M000nwalker/Beyond_Horizon_1/CADS/Worm Gear.gif

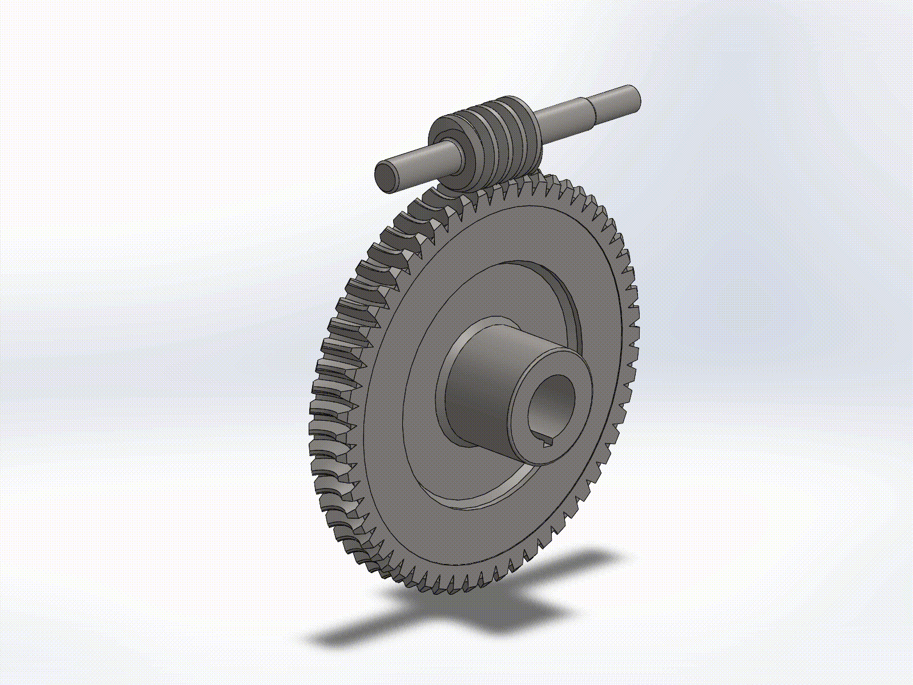
CADS/Worm Gear.gif
