M000nwalker/Beyond_Horizon_1/CADS/worm-gearbox-nema-17-driven-1.snapshot.5/00.png

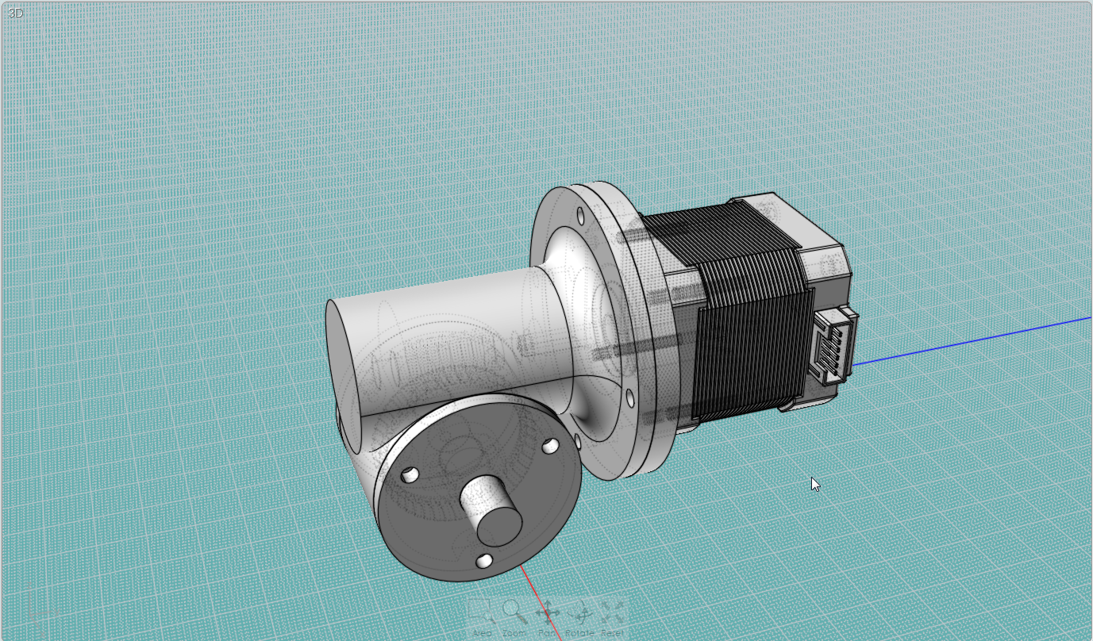
CADS/worm-gearbox-nema-17-driven-1.snapshot.5/00.png
