M000nwalker/Beyond_Horizon_1/Media/photo_2026-10-02_17-45-02.jpg

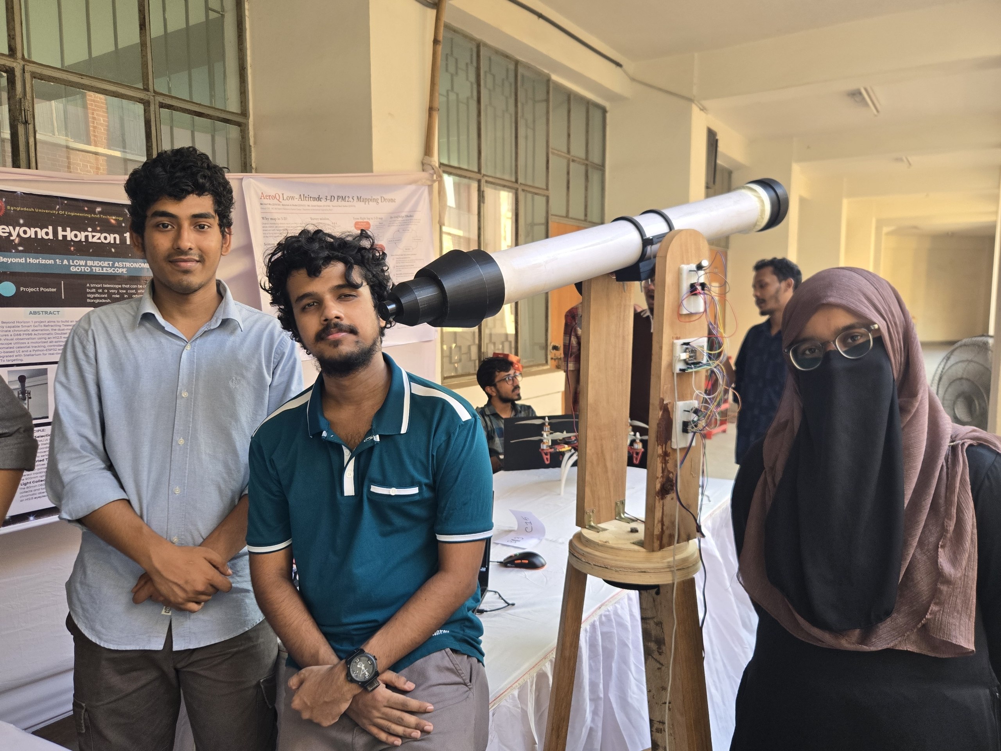
Media/photo_2026-10-02_17-45-02.jpg
