M000nwalker/Beyond_Horizon_1/Media/photo_2026-10-02_17-46-13.jpg

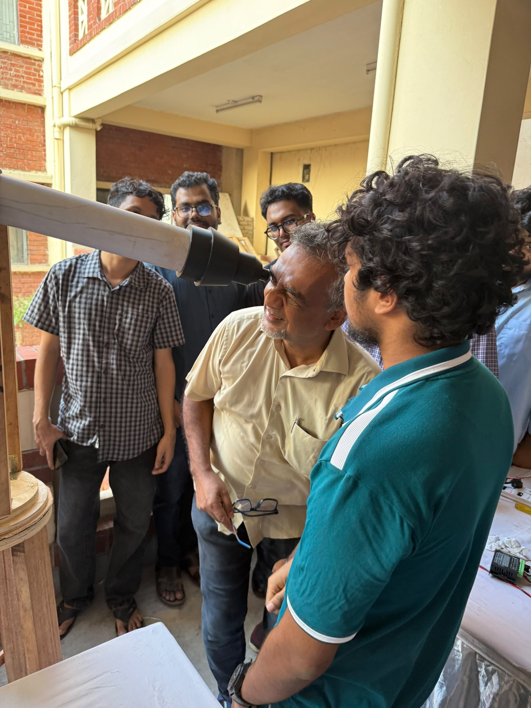
Media/photo_2026-10-02_17-46-13.jpg
