M000nwalker/Beyond_Horizon_1/Web App/Beyond Horizon -1 User Interface/captures/IMG_60D_20260905_001946_005.jpg

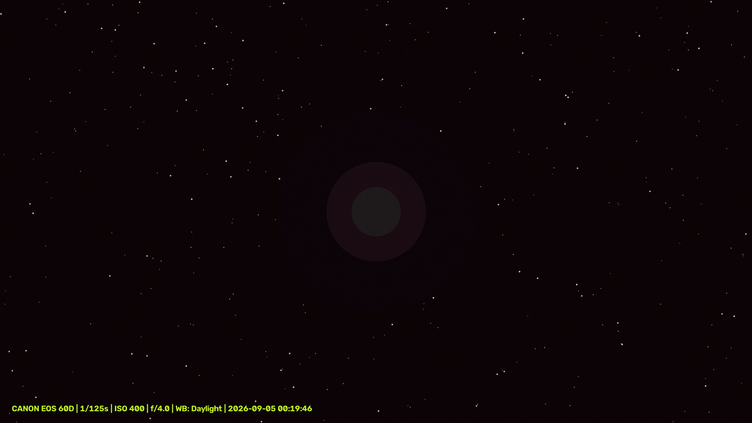
Web App/Beyond Horizon -1 User Interface/captures/IMG_60D_20260905_001946_005.jpg
