M000nwalker/Beyond_Horizon_1/Bill Of Material-BH1/bill_of_materials_BH1.tex

\documentclass[11pt,a4paper]{article}
\usepackage[utf8]{inputenc}
\usepackage[top=2cm, bottom=2cm, left=2.2cm, right=2.2cm]{geometry}
\usepackage{booktabs}
\usepackage{tabularx}
\usepackage{array}

\renewcommand{\familydefault}{\sfdefault}

\begin{document}

\begin{center}
    {\LARGE \textbf{Bill of Materials (BOM)}}\\[1.5ex]
    {\large \textbf{Project BH-1 Expenditure Statement}}\\[1ex]
    \normalsize Date: October 2026 \quad $\vert$ \quad Currency: BDT (Taka)
\end{center}

\vspace{2ex}

\noindent
\renewcommand{\arraystretch}{1.18}
\begin{tabularx}{\linewidth}{@{} c X r @{}}
\toprule
\textbf{SL} & \textbf{Description} & \textbf{Amount (BDT)} \\
\midrule
1  & Optical Parts \& Sourcing (Patuatuli)                        & 1,690 \\
2  & Photocopy \& File Folder                                     & 55 \\
3  & PVC Pipe \& Hacksaw Blade                                    & 180 \\
4  & Document Print                                               & 12 \\
5  & Document Print                                               & 28 \\
6  & Vernier Scale \& ESP32 Microcontroller                       & 1,160 \\
7  & 3D Printing                                                  & 7,500 \\
8  & Material Cutting                                             & 100 \\
9  & Paper \& Screws                                              & 70 \\
10 & Optical Lens                                                 & 6,000 \\
11 & Battery Pack \& Accessories                                  & 2,860 \\
12 & Ball Bearings                                                & 360 \\
13 & Shaft                                                        & 420 \\
14 & Wood                                                         & 1,000 \\
15 & Motor Driver                                                 & 140 \\
16 & Soldering                                        & 160 \\
17 & Carpentry                                                    & 440 \\
18 & Clamps                                                       & 290 \\
19 & Super Glue                                                   & 30 \\
20 & Internet                                                     & 200 \\
21 & Poster \& Conveyance                                         & 280 \\
22 & Optical Eyepiece                                             & 1,600 \\
23 & Motor, Driver \& Component Loss Allowance                    & 2,023 \\
\midrule[\heavyrulewidth]
   & \textbf{Total}                                               & \textbf{26,598} \\
\bottomrule
\end{tabularx}

\end{document}
