M000nwalker/Beyond_Horizon_1/Final Assembly/final assembly.SLDASM

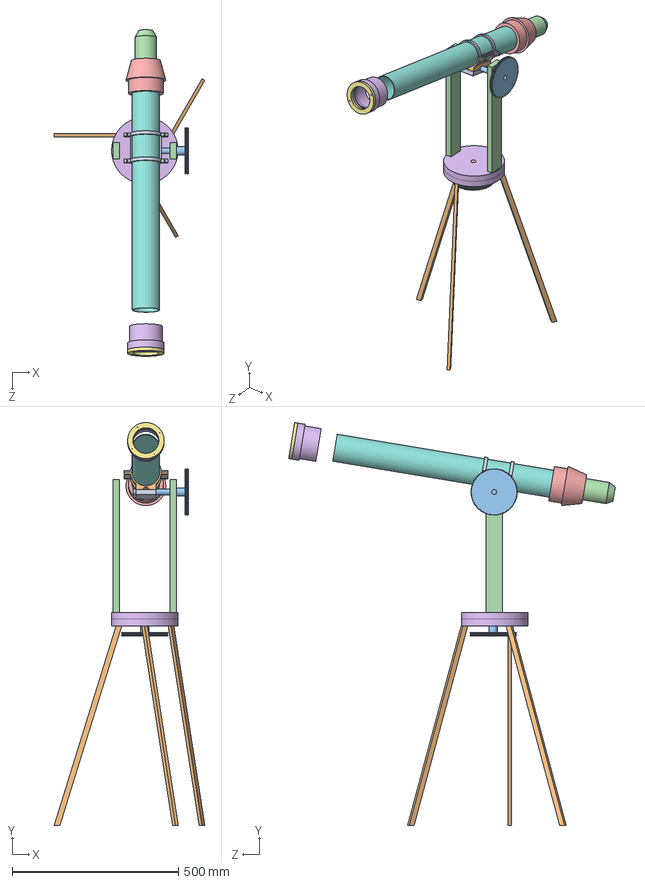
[picture p18: CAD file, 2026-10-15]
Final Assembly/final assembly.SLDASM
453.2 x 1211.3 x 982.1 mm
bases x 2
lower shaft
standing part x 2
upper shaft
Lower Holder
Lower Part with the shaft
PVC pipe
Ready To Print Lens Cap
Ready To Print Lens Cell
Ready To Print Static Focuser
Ready To Print Slider
wormwheel x 2
leg x 3
Upper Holder
