M000nwalker/Beyond_Horizon_1/CADS/upperplatform2.0/gear.SLDASM

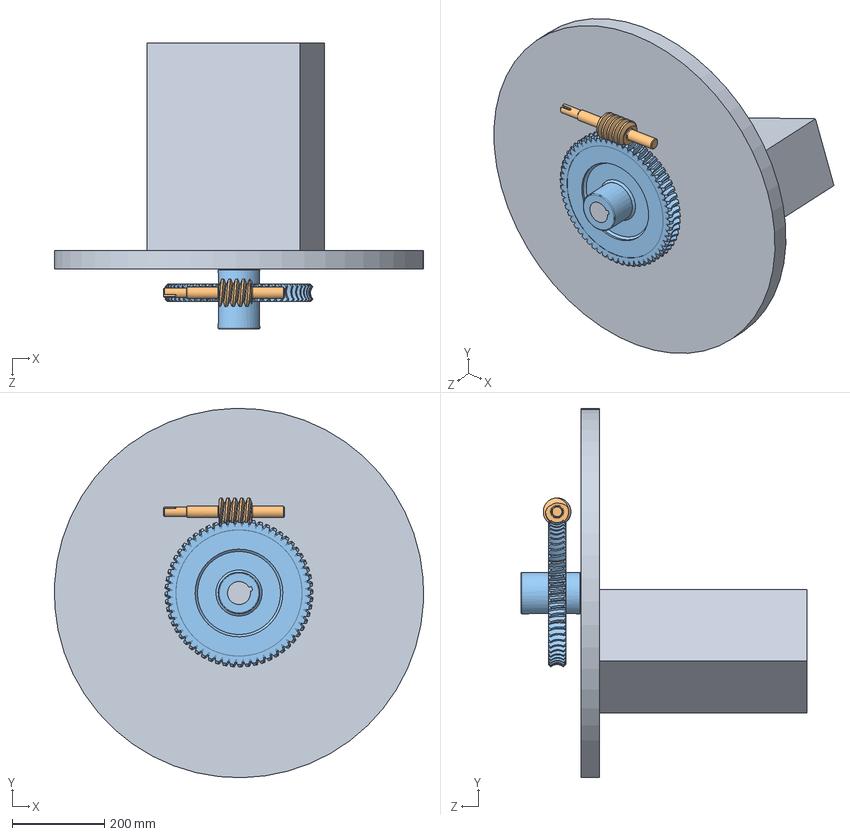
[picture p19: CAD file, 2026-07-25]
CADS/upperplatform2.0/gear.SLDASM
799.1 x 799.9 x 620.0 mm
Upper platform
