M000nwalker/Beyond_Horizon_1/CADS/Printables-1/Assem lower platform.SLDASM

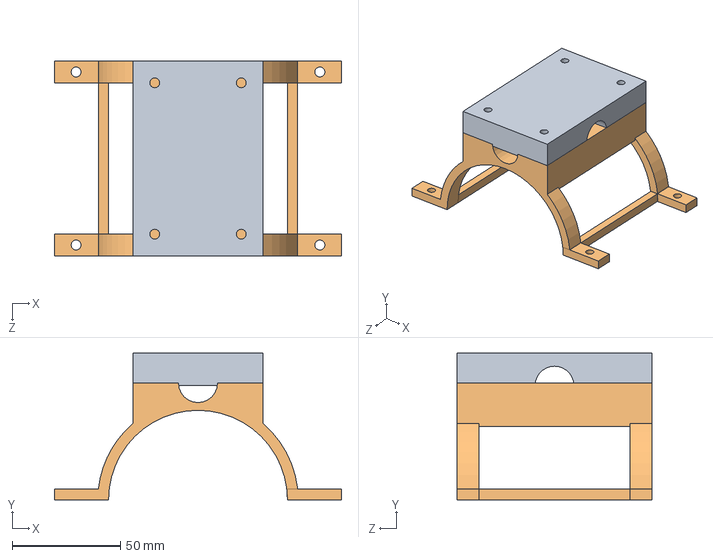
[picture p20: CAD file, 2026-09-06]
CADS/Printables-1/Assem lower platform.SLDASM
132.7 x 67.8 x 90.0 mm
Lower Holder
Lower Part with the shaft
