M000nwalker/Beyond_Horizon_1/CADS/upperplatform2.0/az axis with box.SLDASM

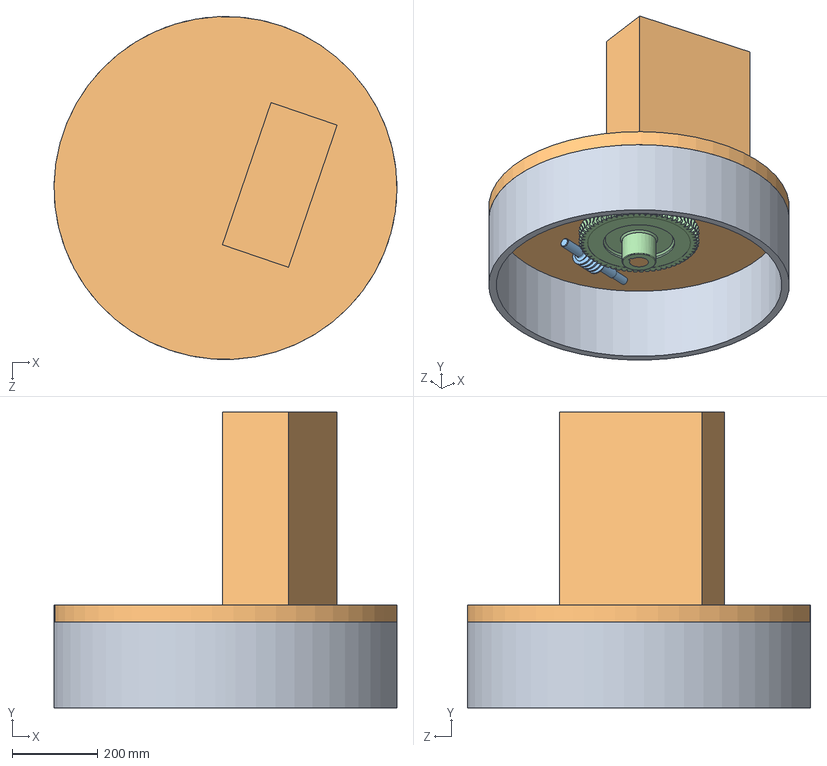
[picture p21: CAD file, 2026-07-25]
CADS/upperplatform2.0/az axis with box.SLDASM
799.9 x 690.0 x 800.0 mm
Upper platform
