M000nwalker/Beyond_Horizon_1/CADS/motor_gearbox.SLDASM

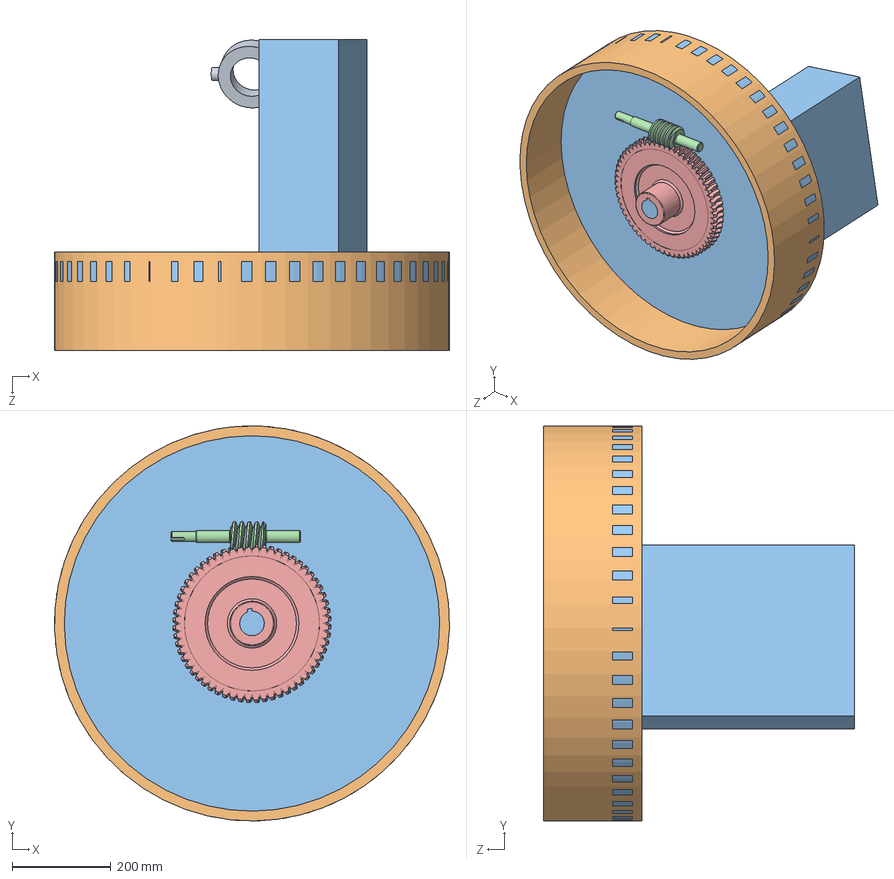
[picture p22: CAD file, 2026-07-25]
CADS/motor_gearbox.SLDASM
799.8 x 799.7 x 630.0 mm
Upper platform
holder
