M000nwalker/Beyond_Horizon_1/Final Assembly/Assembly for print.SLDASM

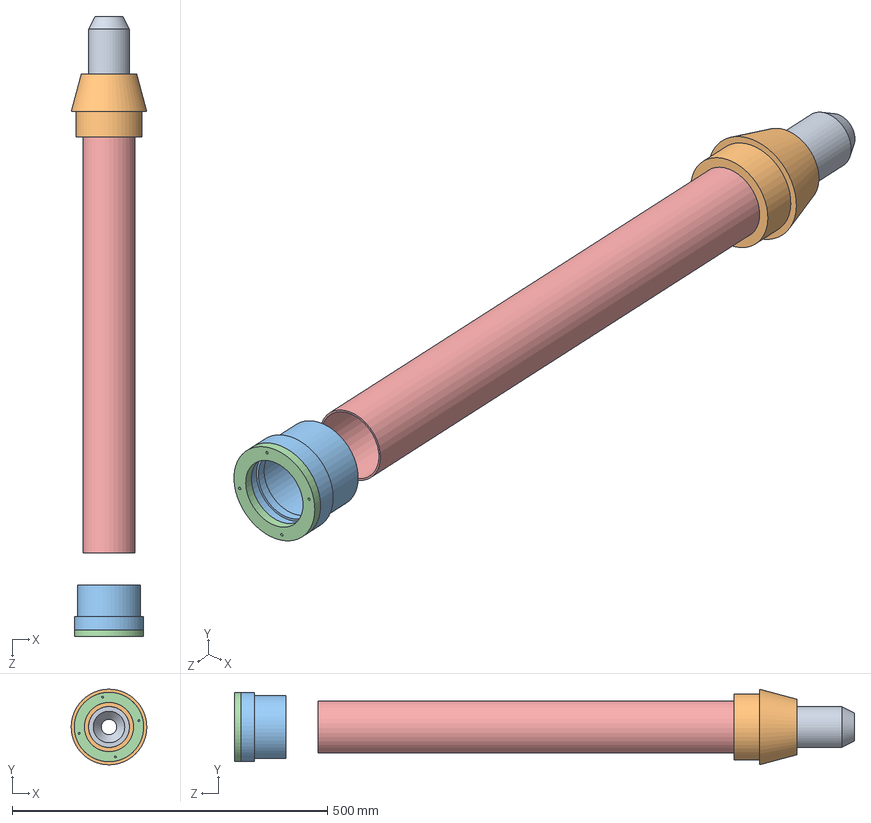
[picture p23: CAD file, 2026-07-30]
Final Assembly/Assembly for print.SLDASM
119.9 x 119.9 x 982.8 mm
PVC pipe
Ready To Print Lens Cap
Ready To Print Lens Cell
Ready To Print Static Focuser
Ready To Print Slider
