M000nwalker/Beyond_Horizon_1/Final Assembly/Main tube.SLDPRT

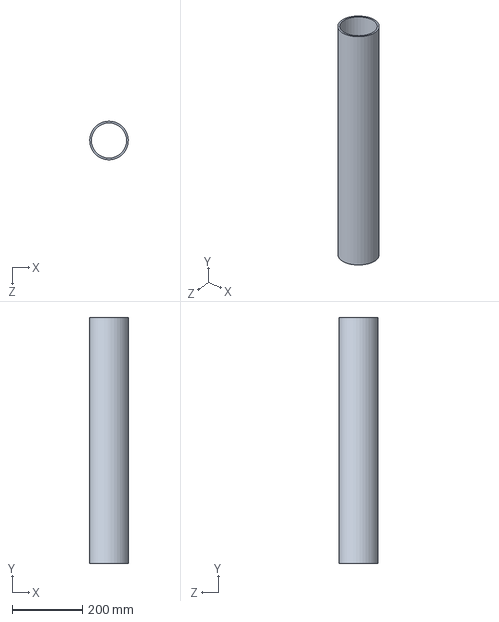
[picture p24: CAD file, 2026-07-12]
Final Assembly/Main tube.SLDPRT
109.9 x 700.0 x 110.0 mm
