M000nwalker/Beyond_Horizon_1/CADS/Worm Assembly.SLDASM

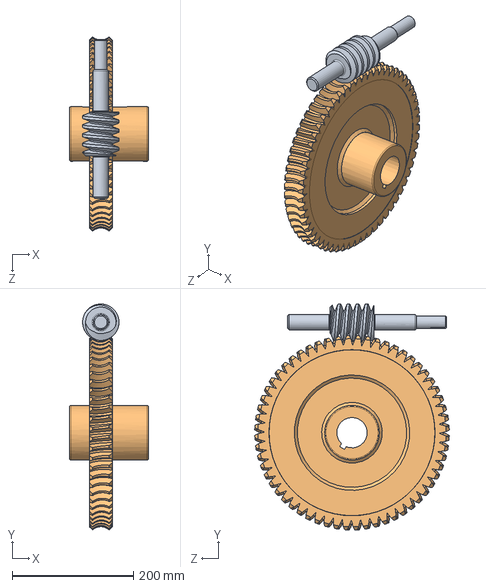
[picture p25: CAD file, 2026-07-12]
CADS/Worm Assembly.SLDASM
130.0 x 372.3 x 320.6 mm
