M000nwalker/Beyond_Horizon_1/CADS/worm gear -assembly.SLDASM

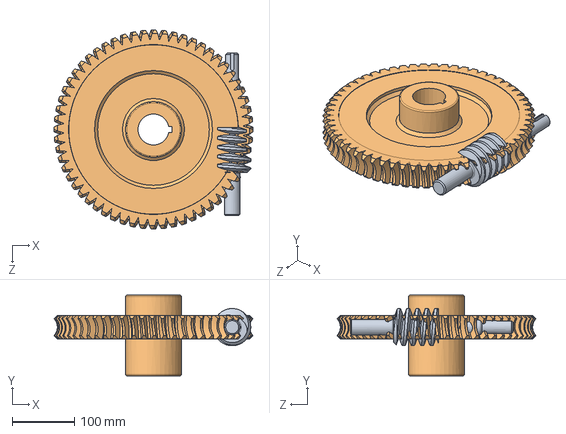
[picture p26: CAD file, 2026-07-12]
CADS/worm gear -assembly.SLDASM
320.7 x 130.0 x 320.7 mm
