M000nwalker/Beyond_Horizon_1/CADS/Final Assembly/upper shaft.SLDPRT

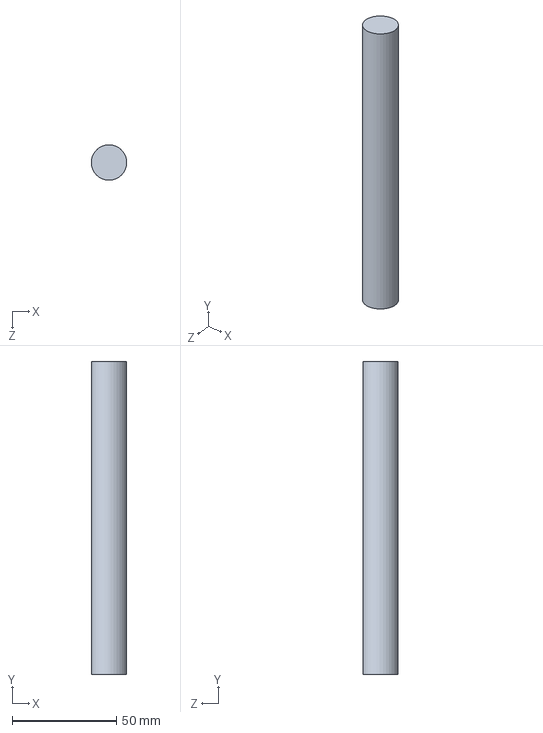
[picture p27: CAD file, 2026-09-24]
CADS/Final Assembly/upper shaft.SLDPRT
17.0 x 150.0 x 17.0 mm
