M000nwalker/Beyond_Horizon_1/CADS/Printables-1/revolver.SLDPRT

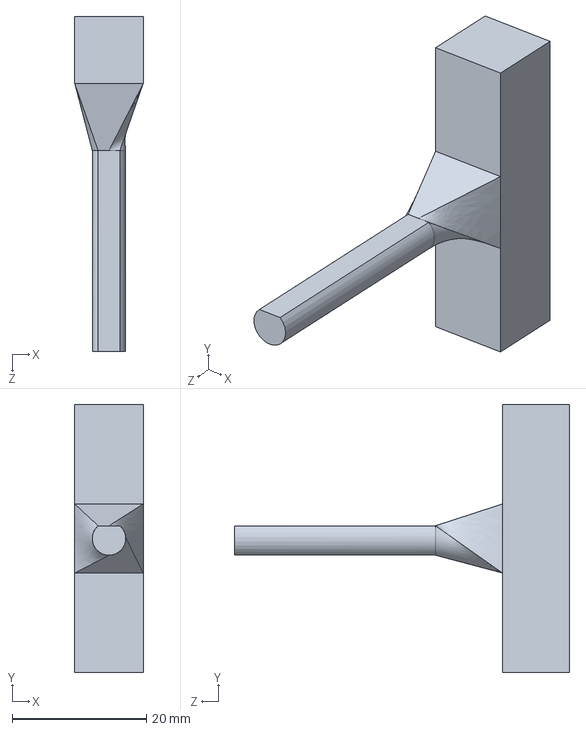
[picture p28: CAD file, 2026-09-07]
CADS/Printables-1/revolver.SLDPRT
10.2 x 40.0 x 50.0 mm
