M000nwalker/Beyond_Horizon_1/CADS/Printables-1/SW2025/Lower Holder.STL

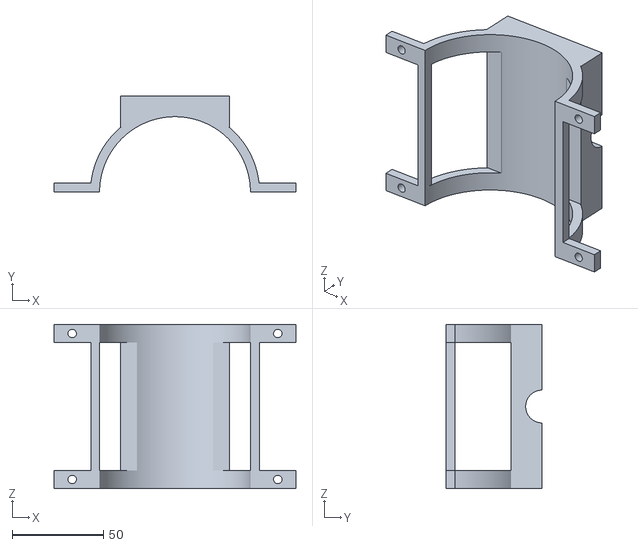
[picture p29: CAD file, 2026-10-11]
CADS/Printables-1/SW2025/Lower Holder.STL
132.7 x 52.8 x 90.0
