M000nwalker/Beyond_Horizon_1/CADS/Printables/Upper Holder.SLDPRT

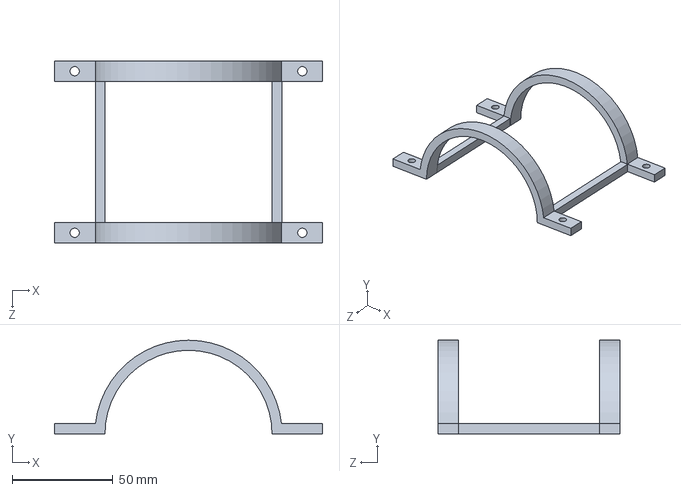
[picture p30: CAD file, 2026-09-04]
CADS/Printables/Upper Holder.SLDPRT
132.7 x 46.3 x 90.0 mm
