M000nwalker/Beyond_Horizon_1/CADS/upperplatform2.0/Upper platform.SLDPRT

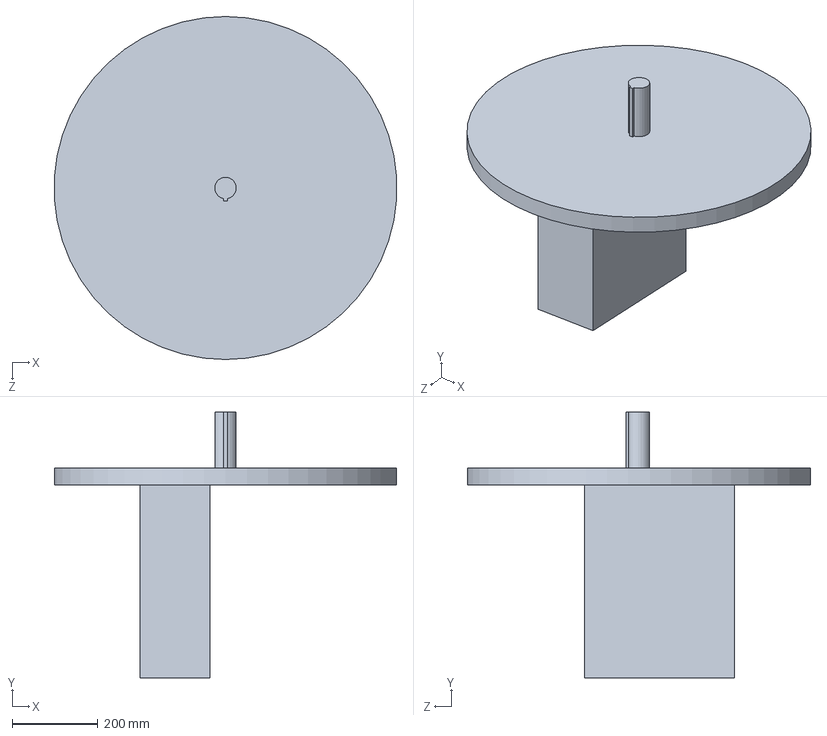
[picture p31: CAD file, 2026-07-25]
CADS/upperplatform2.0/Upper platform.SLDPRT
798.4 x 620.0 x 800.0 mm
