M000nwalker/Beyond_Horizon_1/CADS/Final Assembly/Focuser Static.SLDPRT

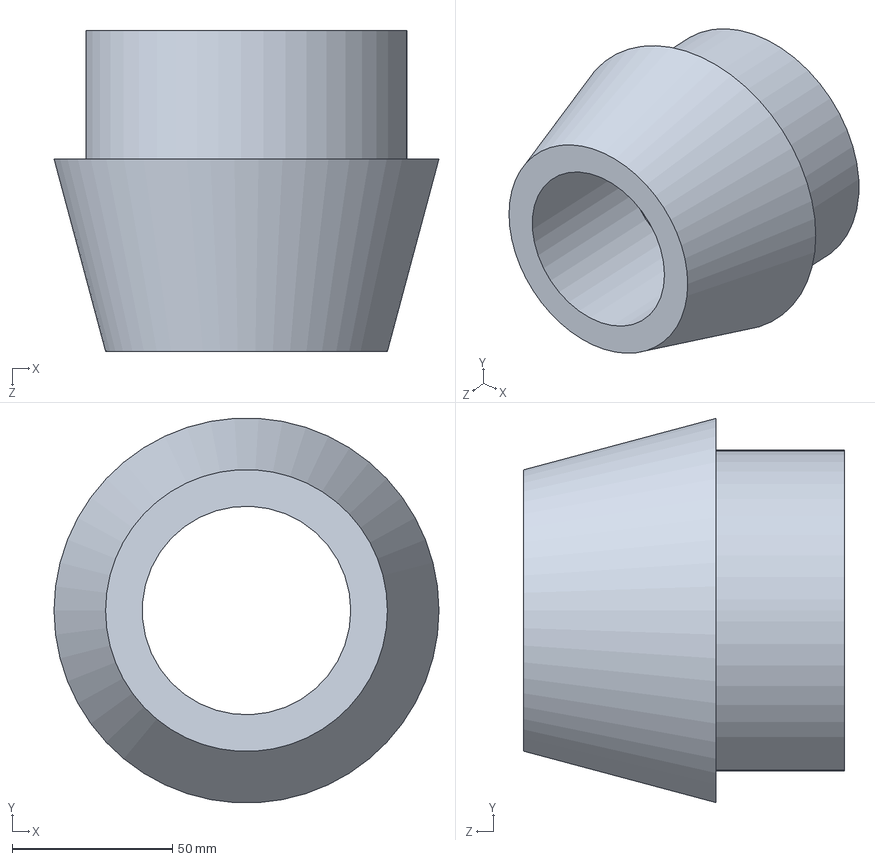
[picture p32: CAD file, 2026-07-12]
CADS/Final Assembly/Focuser Static.SLDPRT
120.0 x 119.8 x 100.0 mm
