M000nwalker/Beyond_Horizon_1/CADS/Optical Tube/Lower Clamp.SLDPRT

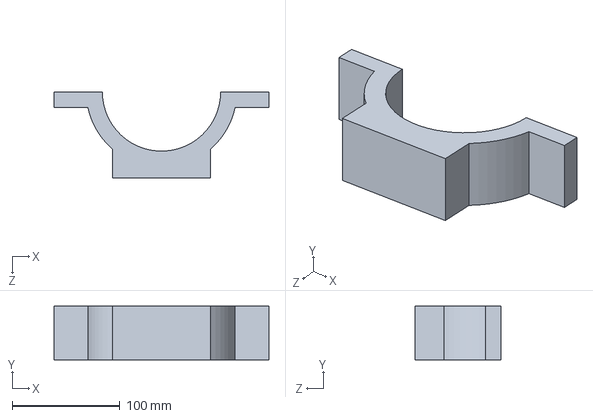
[picture p33: CAD file, 2026-07-26]
CADS/Optical Tube/Lower Clamp.SLDPRT
200.0 x 50.0 x 80.0 mm
