M000nwalker/Beyond_Horizon_1/CADS/Printables-1/Lower Part with the shaft.SLDPRT

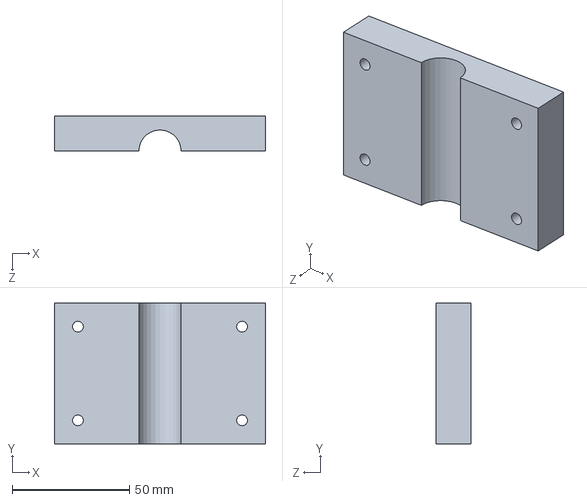
[picture p34: CAD file, 2026-09-06]
CADS/Printables-1/Lower Part with the shaft.SLDPRT
90.0 x 60.0 x 15.0 mm
