M000nwalker/Beyond_Horizon_1/CADS/Printables/Lower Holder.SLDPRT

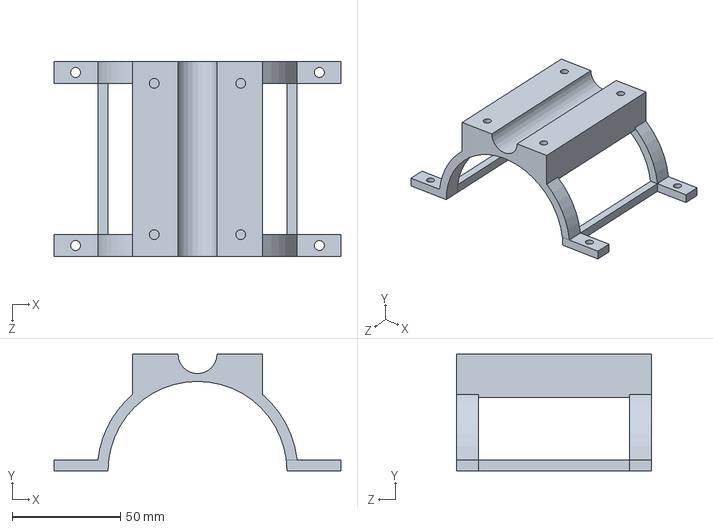
[picture p35: CAD file, 2026-09-02]
CADS/Printables/Lower Holder.SLDPRT
132.7 x 53.9 x 90.0 mm
