M000nwalker/Beyond_Horizon_1/CADS/upperplatform2.0/box.SLDPRT

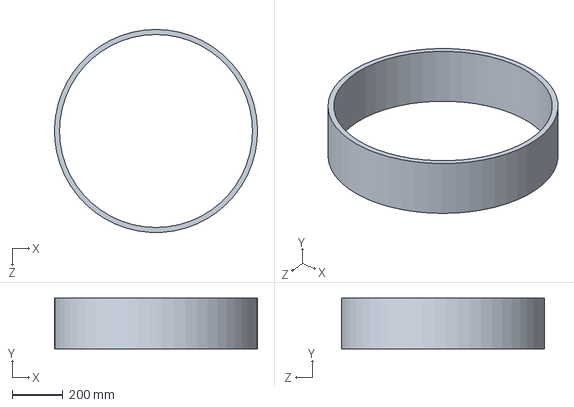
[picture p36: CAD file, 2026-07-25]
CADS/upperplatform2.0/box.SLDPRT
799.6 x 200.0 x 800.0 mm
