M000nwalker/Beyond_Horizon_1/Final Assembly/bases.SLDPRT

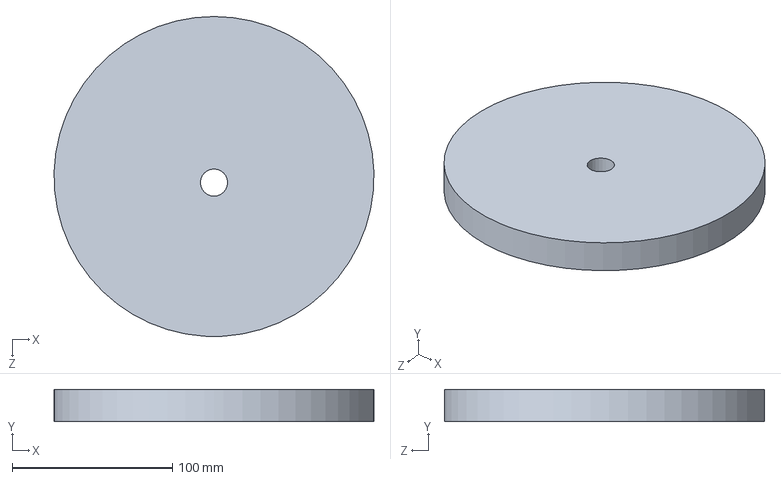
[picture p37: CAD file, 2026-09-24]
Final Assembly/bases.SLDPRT
199.9 x 20.0 x 200.0 mm
