M000nwalker/Beyond_Horizon_1/CADS/Optical Tube/Upper Clamp.SLDPRT

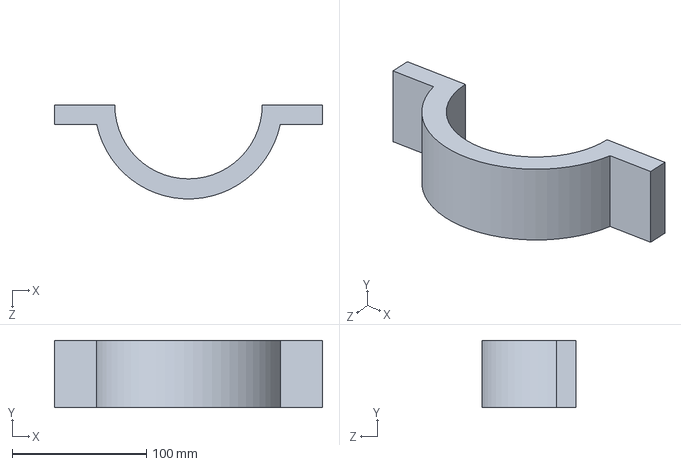
[picture p38: CAD file, 2026-07-26]
CADS/Optical Tube/Upper Clamp.SLDPRT
200.0 x 50.0 x 69.9 mm
