M000nwalker/Beyond_Horizon_1/CADS/Printables-1/Lower Holder.SLDPRT

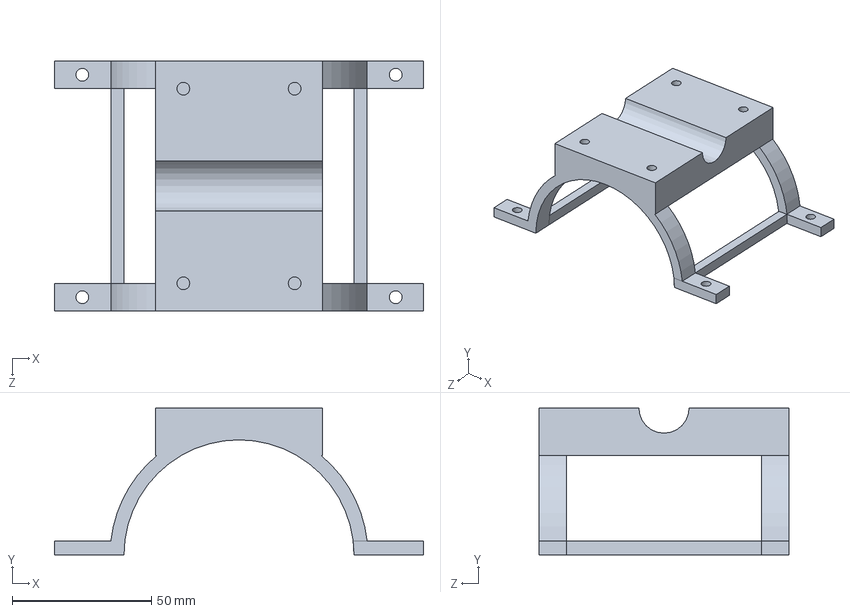
[picture p39: CAD file, 2026-09-06]
CADS/Printables-1/Lower Holder.SLDPRT
132.7 x 52.8 x 90.0 mm
