M000nwalker/Beyond_Horizon_1/CADS/Printables-1/SW2025/revolver.SLDPRT

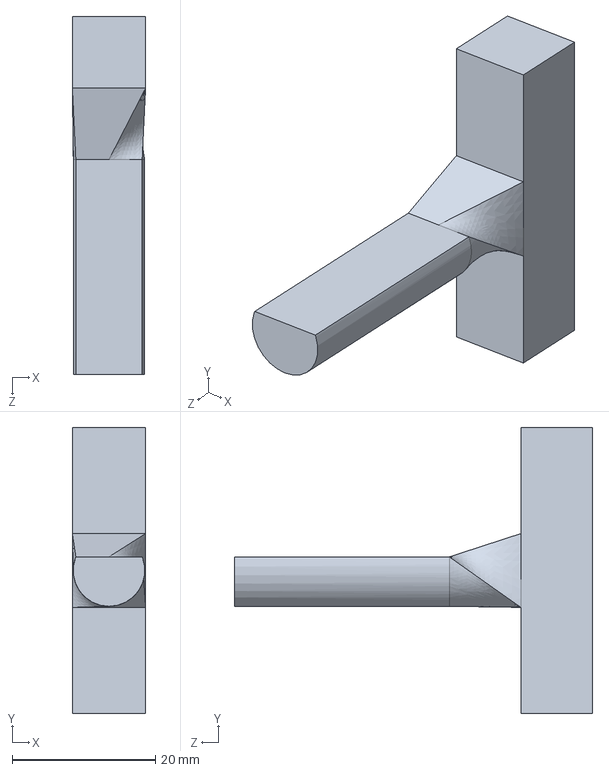
[picture p40: CAD file, 2026-09-06]
CADS/Printables-1/SW2025/revolver.SLDPRT
10.2 x 40.0 x 50.0 mm
