M000nwalker/Beyond_Horizon_1/CADS/Printables/Lower Part with the shaft.SLDPRT

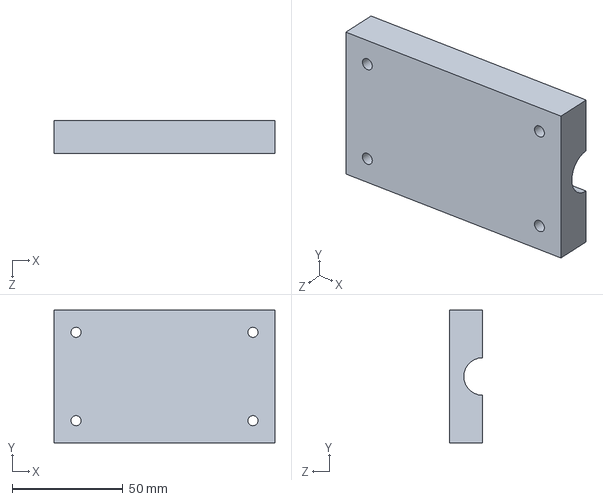
[picture p41: CAD file, 2026-09-01]
CADS/Printables/Lower Part with the shaft.SLDPRT
100.0 x 60.0 x 15.0 mm
