M000nwalker/Beyond_Horizon_1/Final Assembly/leg.SLDPRT

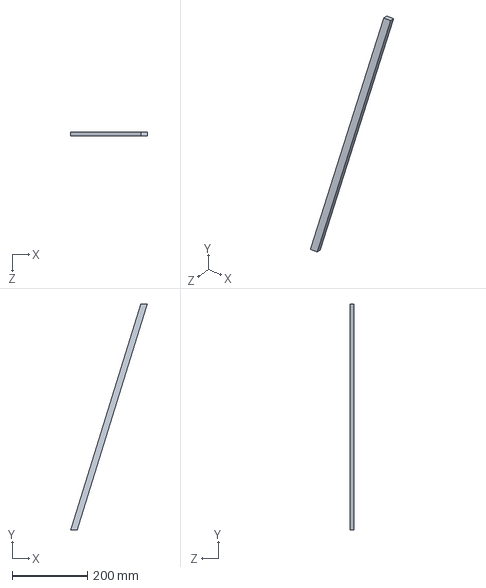
[picture p42: CAD file, 2026-09-24]
Final Assembly/leg.SLDPRT
203.5 x 600.0 x 10.0 mm
