M000nwalker/Beyond_Horizon_1/CADS/Printables/wheel.SLDPRT

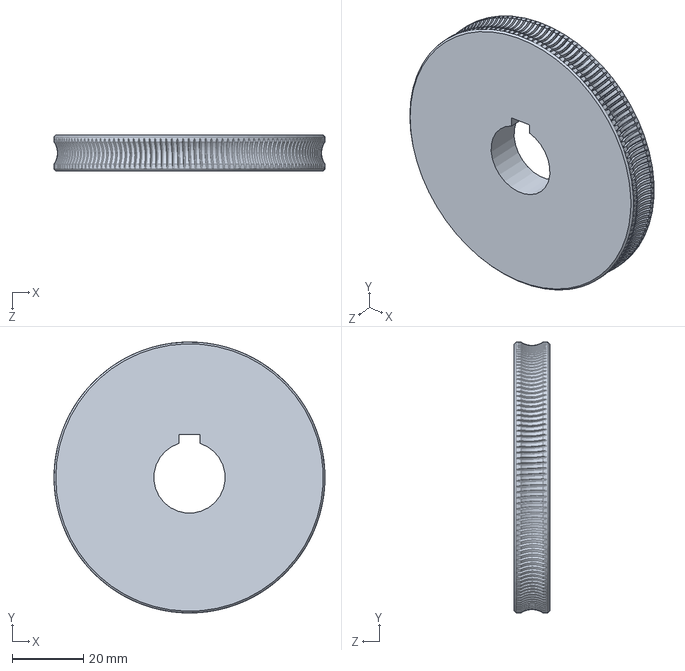
[picture p43: CAD file, 2026-08-12]
CADS/Printables/wheel.SLDPRT
76.0 x 76.0 x 10.0 mm
