M000nwalker/Beyond_Horizon_1/CADS/Ultimate Worm Gear/wheel.SLDPRT

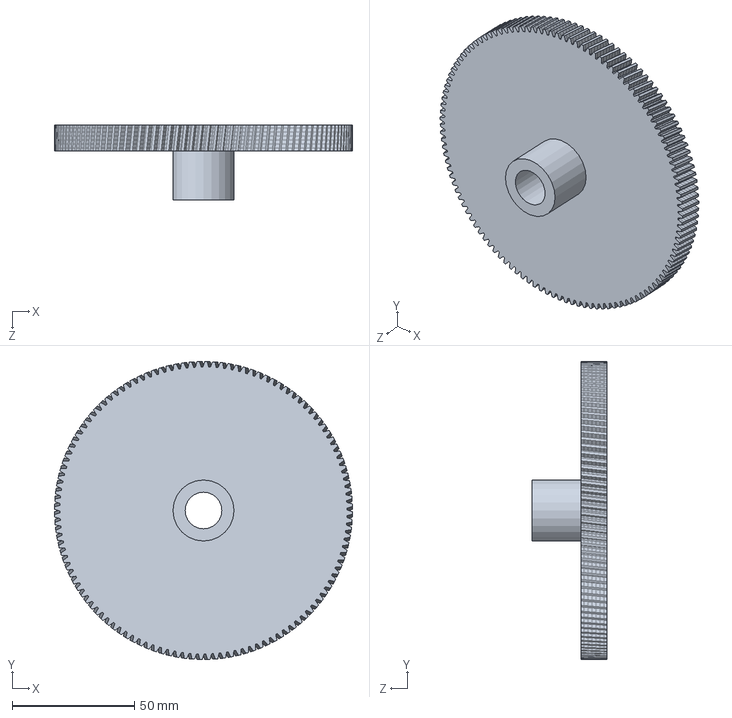
[picture p44: CAD file, 2026-09-06]
CADS/Ultimate Worm Gear/wheel.SLDPRT
122.0 x 122.0 x 30.6 mm
