M000nwalker/Beyond_Horizon_1/Final Assembly/standing part.SLDPRT

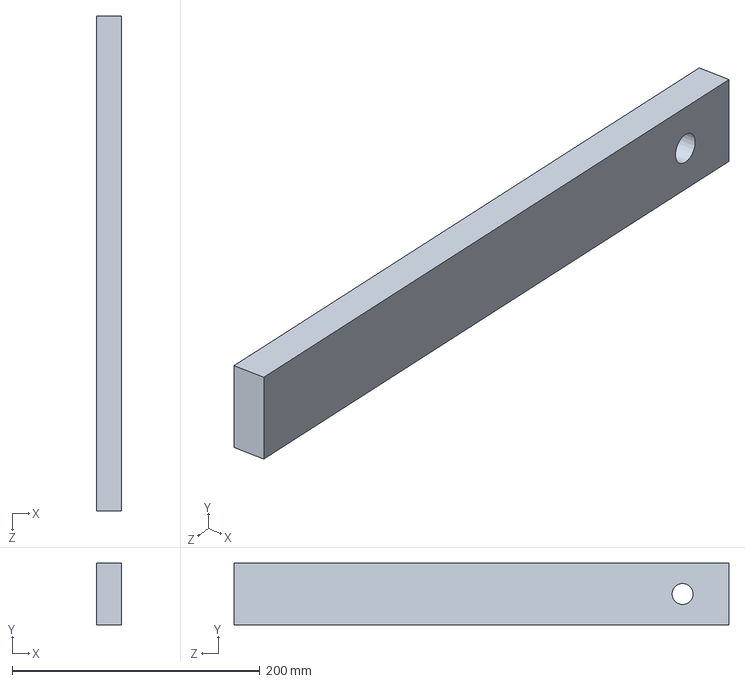
[picture p45: CAD file, 2026-09-24]
Final Assembly/standing part.SLDPRT
20.0 x 50.0 x 400.0 mm
