M000nwalker/Beyond_Horizon_1/CADS/Core.SLDPRT

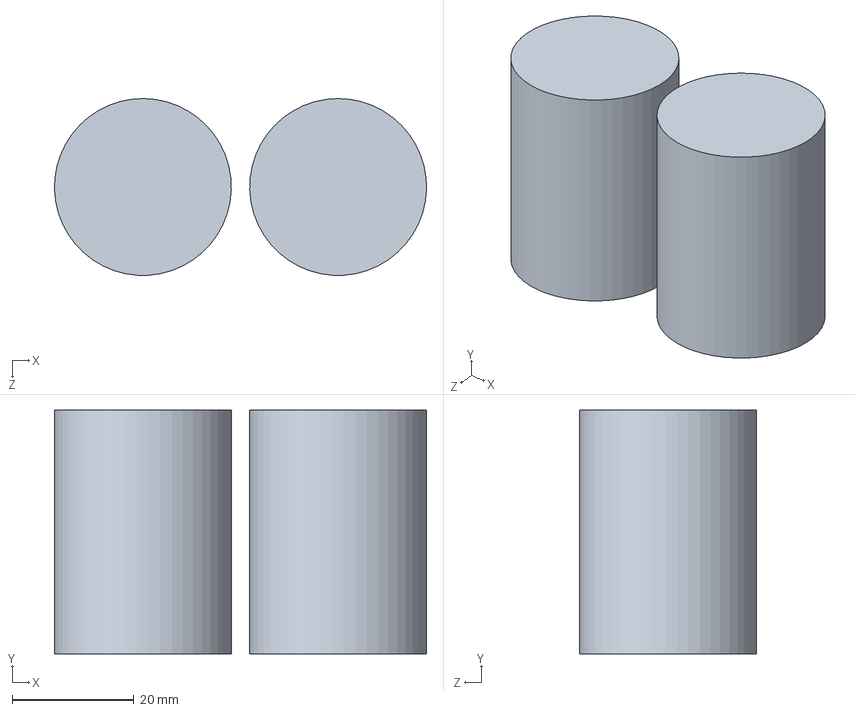
[picture p46: CAD file, 2026-07-26]
CADS/Core.SLDPRT
61.0 x 40.0 x 29.0 mm
