M000nwalker/Beyond_Horizon_1/CADS/Printables-1/wormwheel.SLDPRT

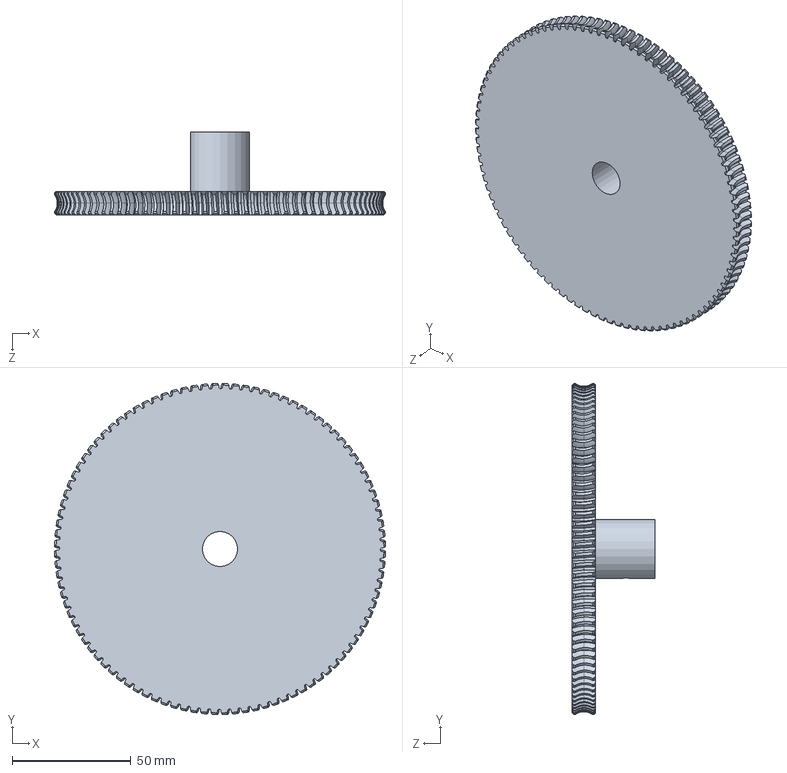
[picture p47: CAD file, 2026-09-02]
CADS/Printables-1/wormwheel.SLDPRT
139.6 x 139.6 x 35.0 mm
