M000nwalker/Beyond_Horizon_1/Final Assembly/lower shaft.SLDPRT

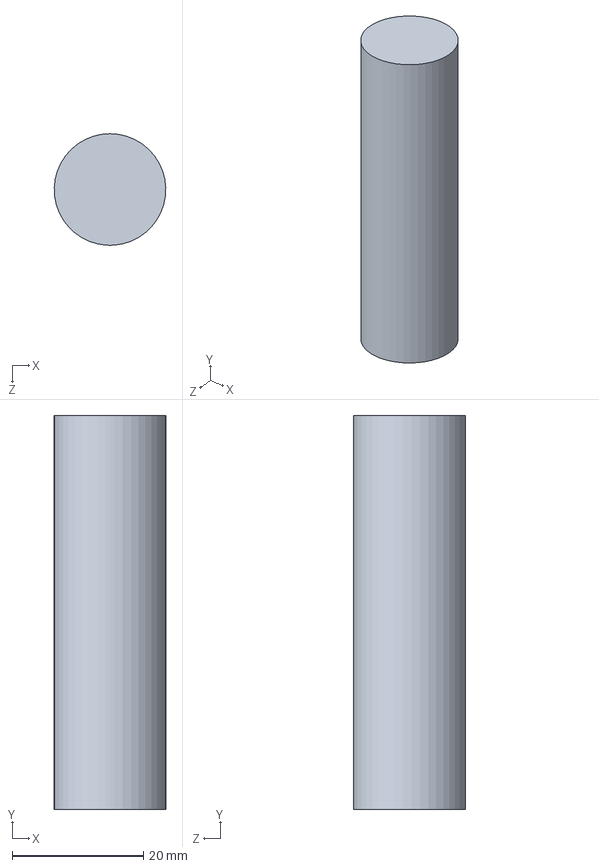
[picture p48: CAD file, 2026-09-24]
Final Assembly/lower shaft.SLDPRT
17.0 x 60.0 x 17.0 mm
