M000nwalker/Beyond_Horizon_1/CADS/upperplatform2.0/Part2.SLDPRT

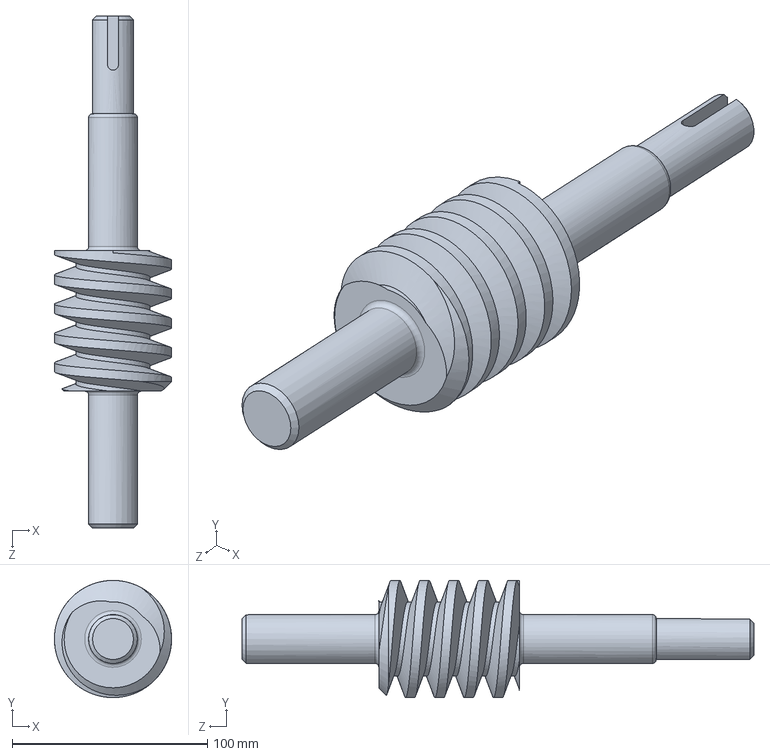
[picture p49: CAD file, 2026-07-12]
CADS/upperplatform2.0/Part2.SLDPRT
60.0 x 60.0 x 262.0 mm
