M000nwalker/Beyond_Horizon_1/CADS/Printables/Ready To Print Lens Cell.SLDPRT

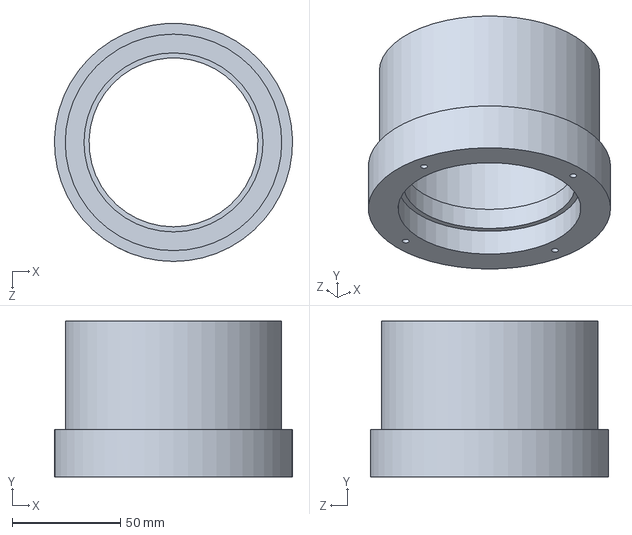
[picture p50: CAD file, 2026-07-30]
CADS/Printables/Ready To Print Lens Cell.SLDPRT
109.9 x 72.0 x 109.9 mm
