M000nwalker/Beyond_Horizon_1/CADS/upperplatform2.0/Part1.SLDPRT

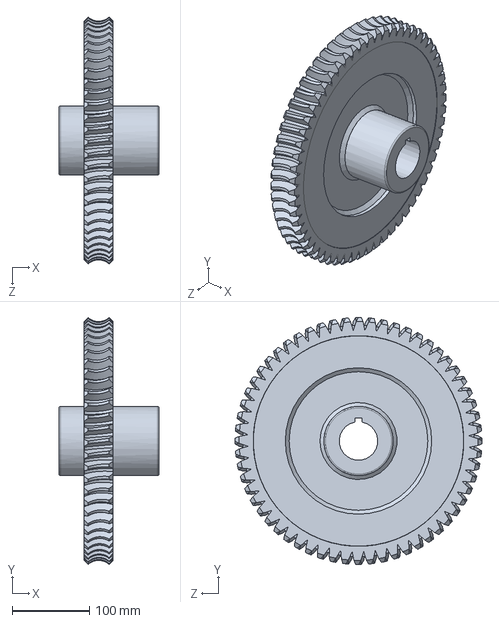
[picture p51: CAD file, 2026-07-12]
CADS/upperplatform2.0/Part1.SLDPRT
130.0 x 320.7 x 320.7 mm
