M000nwalker/Beyond_Horizon_1/CADS/box.SLDPRT

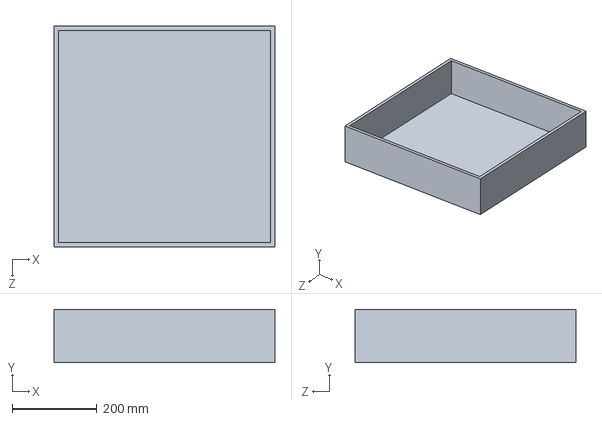
[picture p52: CAD file, 2026-07-25]
CADS/box.SLDPRT
520.0 x 125.0 x 520.0 mm
