M000nwalker/Beyond_Horizon_1/CADS/Printables-1/T-Ring_Adapter_1.25_.stl

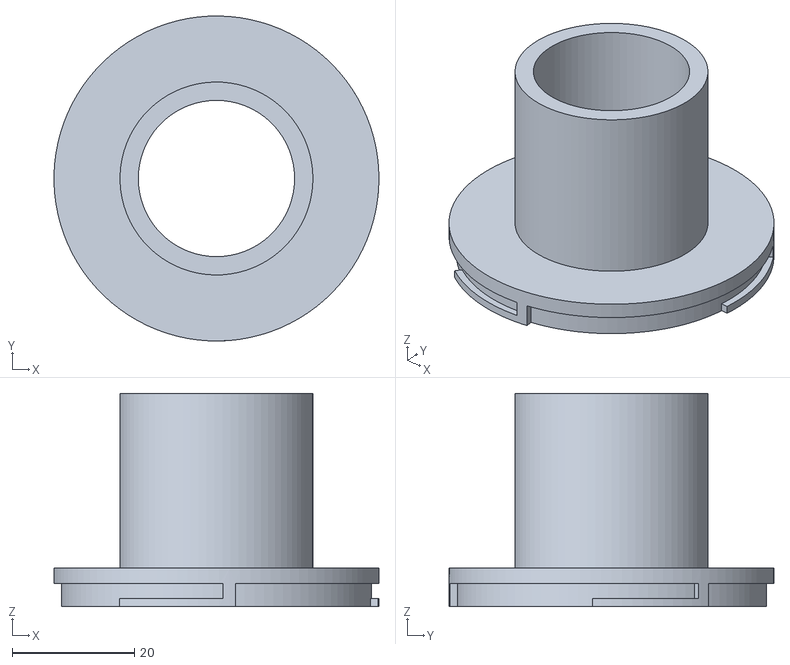
[picture p53: CAD file, 2026-09-01]
CADS/Printables-1/T-Ring_Adapter_1.25_.stl
53.1 x 53.1 x 34.9
