M000nwalker/Beyond_Horizon_1/CADS/Printables/PVC pipe.SLDPRT

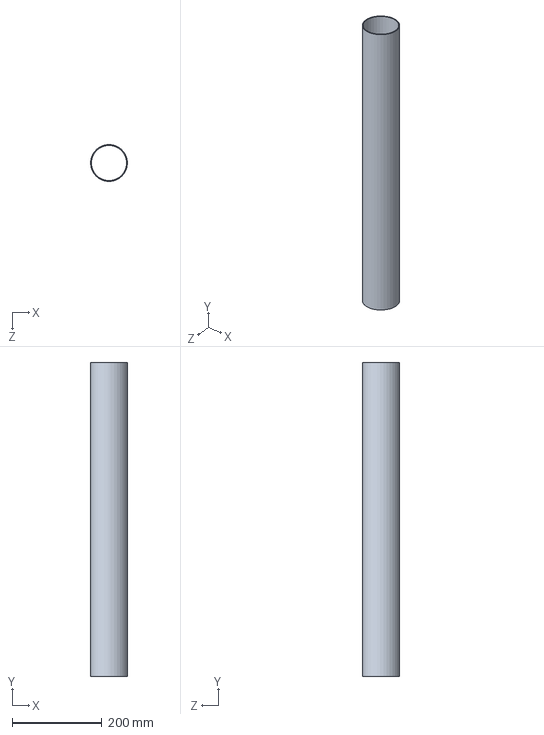
[picture p54: CAD file, 2026-07-30]
CADS/Printables/PVC pipe.SLDPRT
82.2 x 700.0 x 82.3 mm
