M000nwalker/Beyond_Horizon_1/CADS/holder.SLDPRT

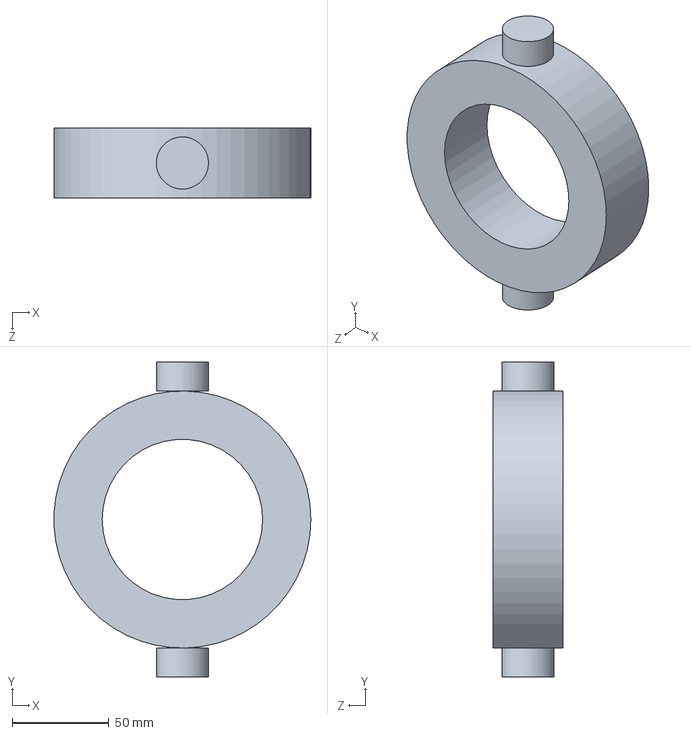
[picture p55: CAD file, 2026-07-25]
CADS/holder.SLDPRT
132.9 x 163.0 x 36.3 mm
