M000nwalker/Beyond_Horizon_1/CADS/Printables/Ready To Print Slider.SLDPRT

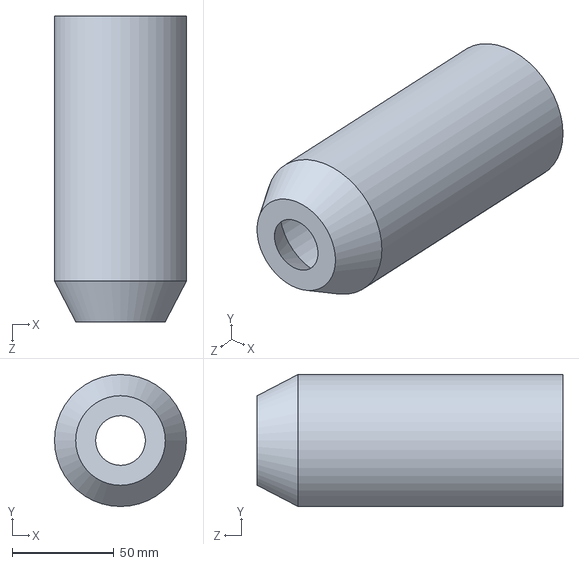
[picture p56: CAD file, 2026-07-30]
CADS/Printables/Ready To Print Slider.SLDPRT
64.8 x 64.8 x 150.0 mm
