M000nwalker/Beyond_Horizon_1/CADS/Printables/Ready To Print Static Focuser.SLDPRT

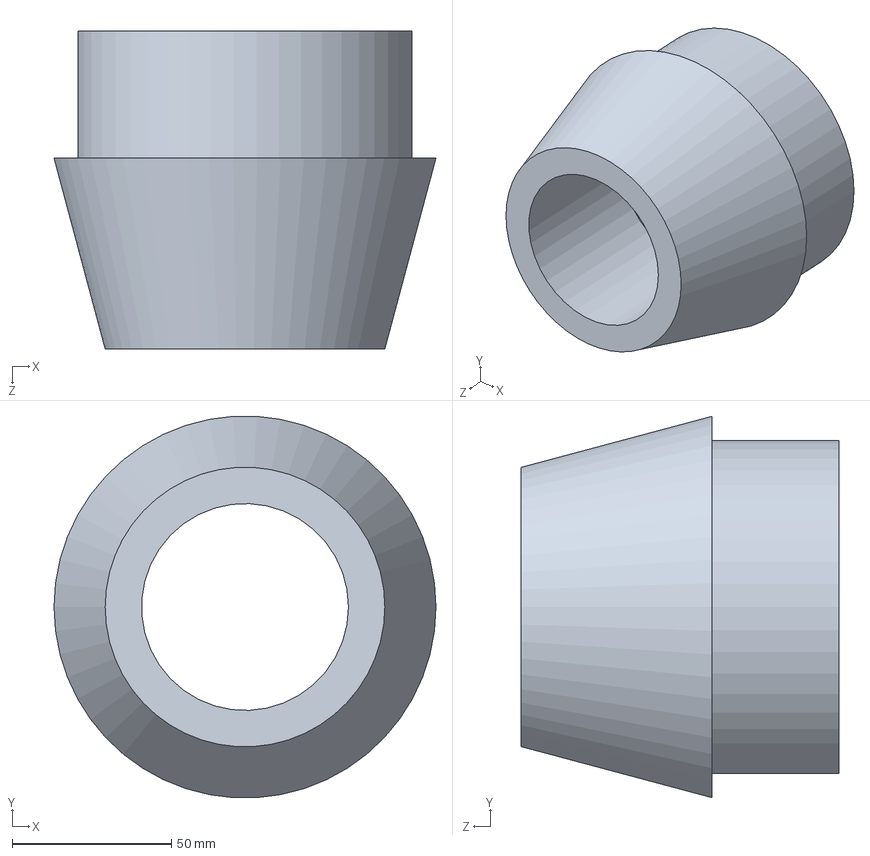
[picture p57: CAD file, 2026-07-30]
CADS/Printables/Ready To Print Static Focuser.SLDPRT
120.0 x 119.8 x 100.0 mm
