M000nwalker/Beyond_Horizon_1/CADS/Printables/Ready To Print Lens Cap.SLDPRT

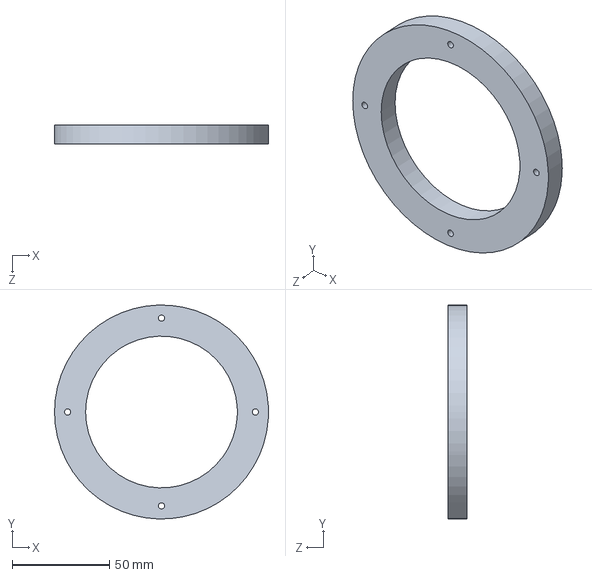
[picture p58: CAD file, 2026-07-27]
CADS/Printables/Ready To Print Lens Cap.SLDPRT
110.0 x 110.0 x 10.0 mm
