M000nwalker/Beyond_Horizon_1/CADS/New Upper Platform.SLDPRT

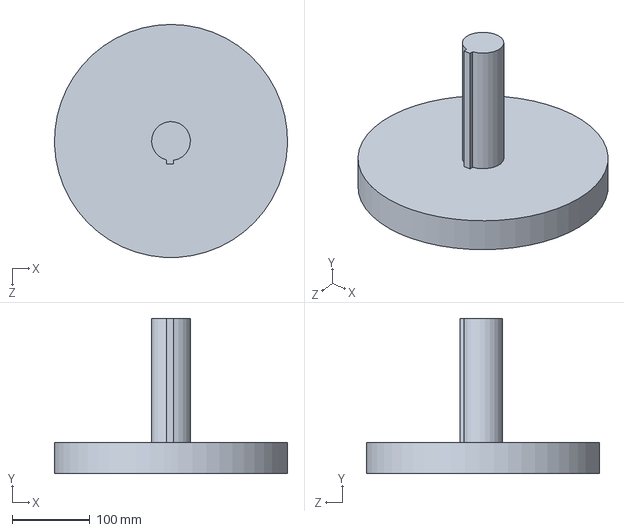
[picture p59: CAD file, 2026-07-23]
CADS/New Upper Platform.SLDPRT
299.9 x 200.0 x 300.0 mm
