M000nwalker/Beyond_Horizon_1/CADS/Upper platform.SLDPRT

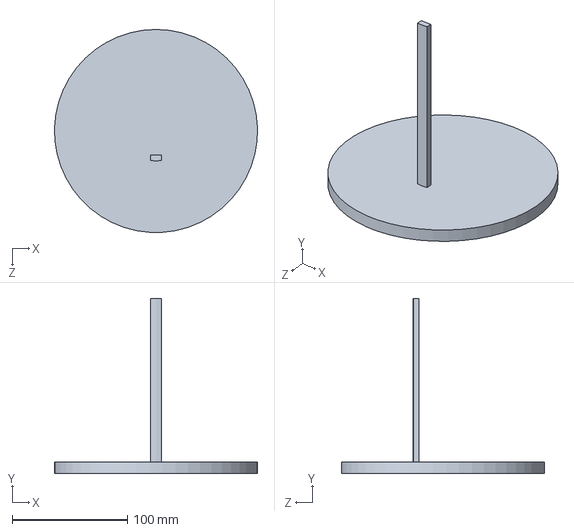
[picture p60: CAD file, 2026-07-18]
CADS/Upper platform.SLDPRT
175.9 x 152.0 x 176.0 mm
