M000nwalker/Beyond_Horizon_1/CADS/Lens cap.SLDPRT

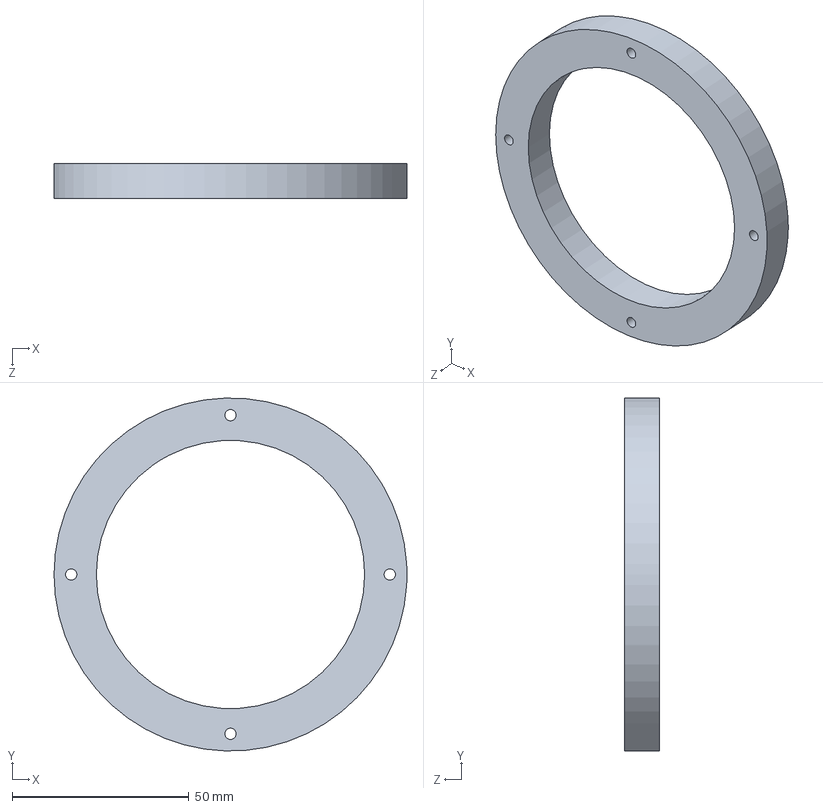
[picture p61: CAD file, 2026-07-12]
CADS/Lens cap.SLDPRT
100.0 x 100.0 x 10.0 mm
