M000nwalker/Beyond_Horizon_1/Final Assembly/Lens Cell.SLDPRT

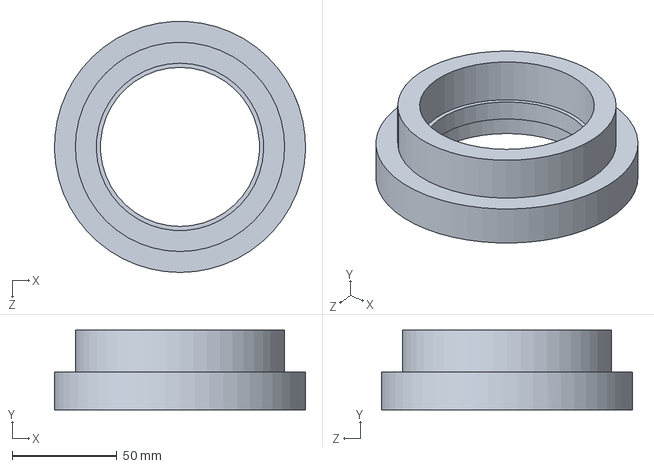
[picture p62: CAD file, 2026-07-12]
Final Assembly/Lens Cell.SLDPRT
119.9 x 38.0 x 119.9 mm
