M000nwalker/Beyond_Horizon_1/Final Assembly/Draw tube.SLDPRT

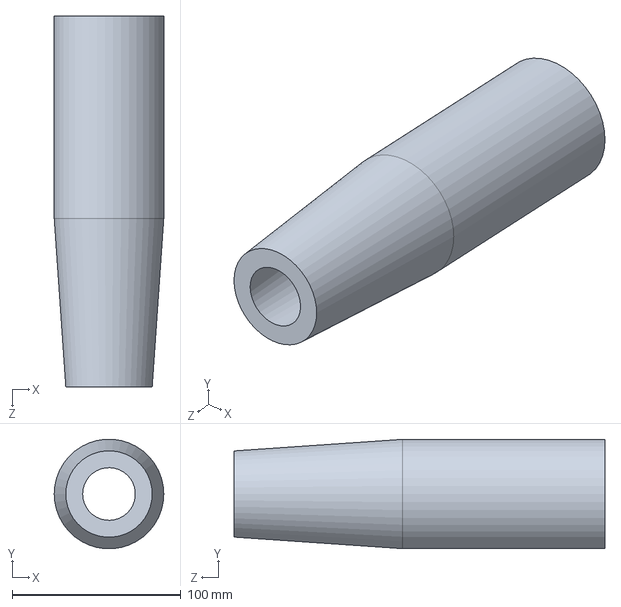
[picture p63: CAD file, 2026-07-12]
Final Assembly/Draw tube.SLDPRT
65.0 x 64.8 x 220.0 mm
