M000nwalker/Beyond_Horizon_1/CADS/Optical Tube/OTA With Clamp.SLDASM

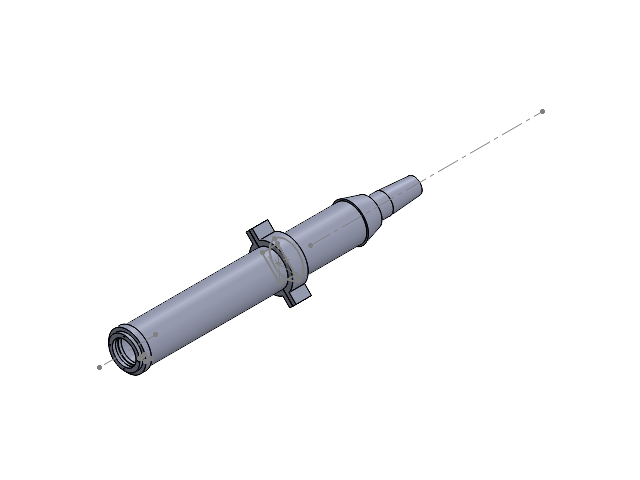
[picture p64: CAD file, 2026-07-30]
CADS/Optical Tube/OTA With Clamp.SLDASM
Lens cap
Lens Cell
Main tube
Focuser Static
Draw tube
Lower Clamp
Upper Clamp
