M000nwalker/Beyond_Horizon_1/CADS/final worm/finalfinal.SLDASM

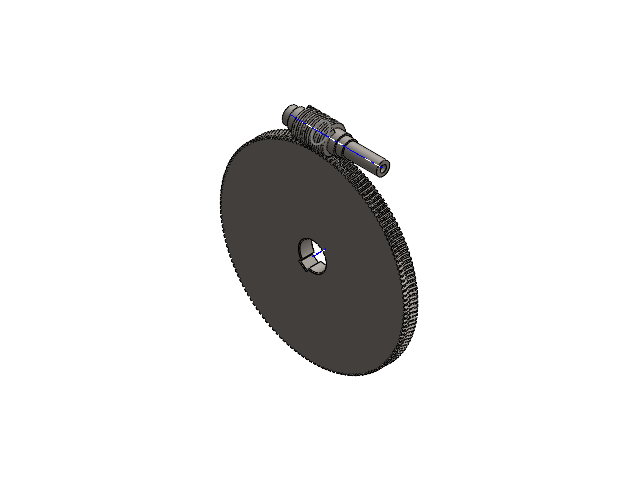
[picture p65: CAD file, 2026-08-24]
CADS/final worm/finalfinal.SLDASM
wheel
wormscrew
