M000nwalker/Beyond_Horizon_1/CADS/OTA With Clamp.SLDASM

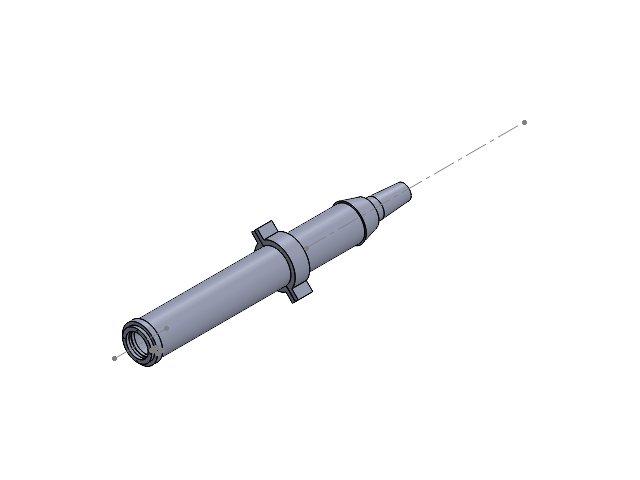
[picture p66: CAD file, 2026-07-26]
CADS/OTA With Clamp.SLDASM
Lens cap
Lens Cell
Main tube
Focuser Static
Draw tube
Lower Clamp
Upper Clamp
