M000nwalker/Beyond_Horizon_1/CADS/Lens cap and cell.SLDASM

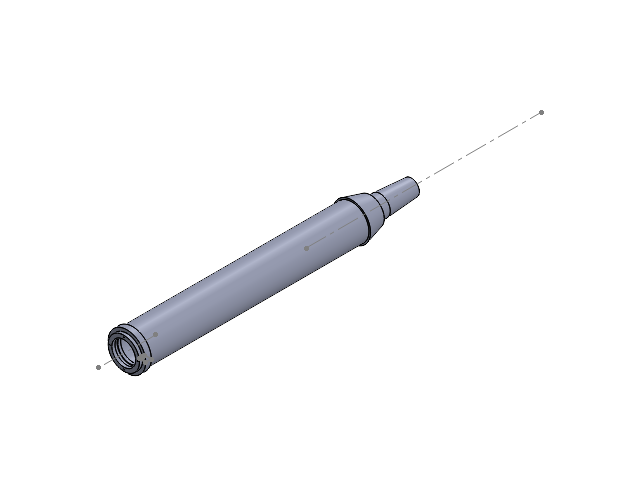
[picture p67: CAD file, 2026-07-26]
CADS/Lens cap and cell.SLDASM
Lens cap
Lens Cell
Main tube
Focuser Static
Draw tube
