M000nwalker/Beyond_Horizon_1/CADS/Printables/WORMGEAR.SLDASM

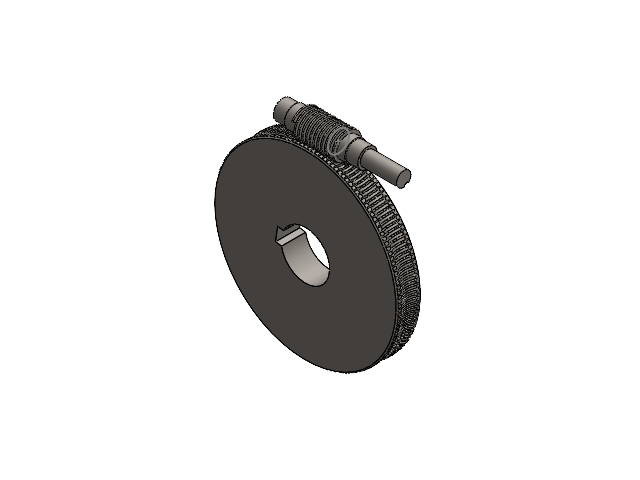
[picture p68: CAD file, 2026-08-12]
CADS/Printables/WORMGEAR.SLDASM
wheel
wormscrew
