M000nwalker/Beyond_Horizon_1/Final Assembly/Lens cap and cell.SLDASM

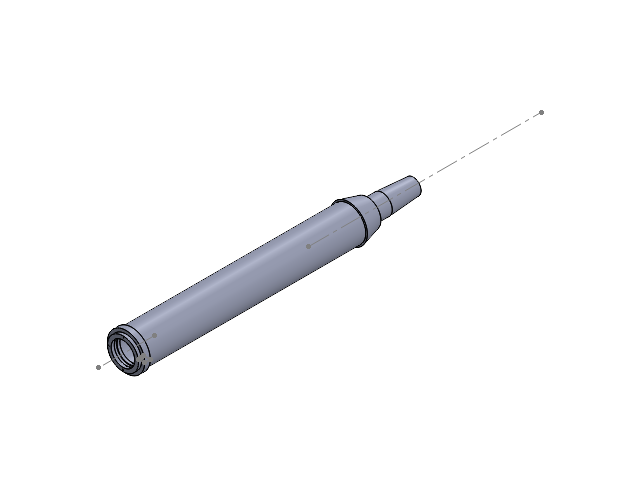
[picture p69: CAD file, 2026-07-26]
Final Assembly/Lens cap and cell.SLDASM
Lens cap
Lens Cell
Main tube
Focuser Static
Draw tube
