M000nwalker/Beyond_Horizon_1/(list of files, cad)

Other CAD files:
CADS/upperplatform2.0/alt rotation.SLDASM
Final Assembly/Assem lower platform.SLDASM
CADS/gear.SLDASM
CADS/azimuthal axis.SLDASM
CADS/Mount assembly.SLDASM
CADS/Upper Holder.SLDPRT
CADS/Lower Clamp.SLDPRT
CADS/Printables-1/Upper Holder.SLDPRT
Final Assembly/Lower Holder.SLDPRT
Final Assembly/Lower Holder finalized.STL
Final Assembly/Lower Part with the shaft.SLDPRT
Final Assembly/wormwheel.SLDPRT
CADS/Printables-1/Lower Holder.STL
CADS/Printables-1/Lower Part with the shaft.STL
CADS/Printables-1/SW2025/wormscrew.SLDPRT
CADS/Printables-1/Upper Holder.STL
CADS/Printables-1/revolver.STL
CADS/Printables-1/wormscrew.SLDPRT
CADS/Printables/Lower Holder.STL
CADS/Printables/Upper Holder.STL
CADS/Printables/wheel.STL
CADS/Printables/wormscrew.SLDPRT
CADS/Ultimate Worm Gear/wheel.STL
CADS/Ultimate Worm Gear/worm screw.SLDPRT
CADS/Ultimate Worm Gear/worm screw.STL
CADS/Ultimate Worm Gear/worm screw2.STL
CADS/Ultimate Worm Gear/worm screw2025.SLDPRT
CADS/final worm/wormscrew.SLDPRT
CADS/final worm/wormwheel.SLDPRT
CADS/worm screw.SLDPRT
Final Assembly/wormscrew.SLDPRT
