M000nwalker/Beyond_Horizon_1/(commit log)

2026-07-11 Renamed The Model
    Optical Simulation Model of the Objective Lens
2026-07-11 Comsol Model of the Objective Lens
    In this model we carried out FEA of our Objective Lens.
2026-07-12 Rough Cads
    [Draw tube.SLDPRT, Focuser Static.SLDPRT, Lens Cell.SLDPRT, Lens cap and cell.SLDASM, Lens cap.SLDPRT, Main tube.SLDPRT, Mount assembly.SLDASM, Part1.SLDPRT]
2026-07-19 Edited the size of the upper platform
    [Assem3.SLDASM]
2026-07-20 Few Updates
    [azimuthal axis.SLDASM]
2026-07-23 Upper Platform Fixed
    [New Upper Platform.SLDPRT, Worm Wheel.SLDPRT]
2026-07-25 Remove loose CAD files
    [box.SLDPRT]
2026-07-25 Add upper platform CAD folder
    [Upper platform.SLDPRT, box.SLDPRT, gear.SLDASM, holder.SLDPRT, motor_gearbox.SLDASM]
2026-07-25 Assembled the box
    [Assem3.SLDASM, Part1.SLDPRT, Part2.SLDPRT, Upper platform.SLDPRT, Worm Wheel.SLDPRT, alt rotation.SLDASM, az axis with box.SLDASM, box.SLDPRT]
2026-07-26 Designed and Assembled The Clamp
    [Core.SLDPRT, Draw tube.SLDPRT, Focuser Static.SLDPRT, Lens Cell.SLDPRT, Lens cap and cell.SLDASM, Lens cap.SLDPRT, Lower Clamp.SLDPRT, Main tube.SLDPRT]
2026-07-27 Made few CADs Print Ready
    [Assembly for print.SLDASM, PVC pipe.SLDPRT, Ready To Print Lens Cap.SLDPRT, Ready To Print Lens Cell.SLDPRT]
2026-07-30 Finalized focuser
    [Assembly for print.SLDASM, OTA With Clamp.SLDASM, PVC pipe.SLDPRT, Ready To Print Lens Cell.SLDPRT, Ready To Print Slider.SLDPRT, Ready To Print Static Focuser.SLDPRT]
2026-08-26 fixed wheel
    [wheel (1).SLDPRT, wheel.STL]
2026-08-26 Prepared STL
2026-09-01 Finalized Lots of CAD
    [Lower Holder.SLDPRT, Lower Part with the shaft.SLDPRT, T-Ring_Adapter_1.25_.stl, Upper Holder.SLDPRT, revolver.SLDPRT, wormscrew.SLDPRT, wormwheel.SLDPRT]
2026-09-02 dimensions edited
    [Lower Part with the shaft.SLDPRT, Upper Holder.SLDPRT, wormscrew.SLDPRT, wormwheel.SLDPRT]
2026-09-04 Fixed Upper Holder
    [Upper Holder.SLDPRT]
2026-09-06 ami solidworks er boss
    [Assem lower platform.SLDASM, Lower Holder.SLDPRT, Lower Part with the shaft.SLDPRT]
2026-09-06 Designed Gears
    [wheel.SLDPRT, worm screw.SLDPRT]
2026-09-07 Fixed The Lower Holder
    [Lower Holder.SLDPRT]
2026-09-24 Wrote and optimized the logics
    [Assem lower platform.SLDASM, Lower Holder finalized.STL, Lower Holder.SLDPRT]
2026-09-24 Assembly Done - Final one
    [Assem lower platform.SLDASM, Assembly for print.SLDASM, Draw tube.SLDPRT, Focuser Static.SLDPRT, Lens Cell.SLDPRT, Lens cap and cell.SLDASM, Lens cap.SLDPRT, Lower Holder finalized.STL]
2026-10-02 Almost Finalized Documentation
    [Assem lower platform.SLDASM, Assembly for print.SLDASM, Core.SLDPRT, Draw tube.SLDPRT, Focuser Static.SLDPRT, Lens Cell.SLDPRT, Lens cap and cell.SLDASM, Lens cap.SLDPRT]
2026-10-15 Finalized The Assembly
