M000nwalker/Beyond_Horizon_1/(notices)

Notices in the files:
README.md:
License: MIT
