M000nwalker/Beyond_Horizon_1/Media/20260926_014432.jpg

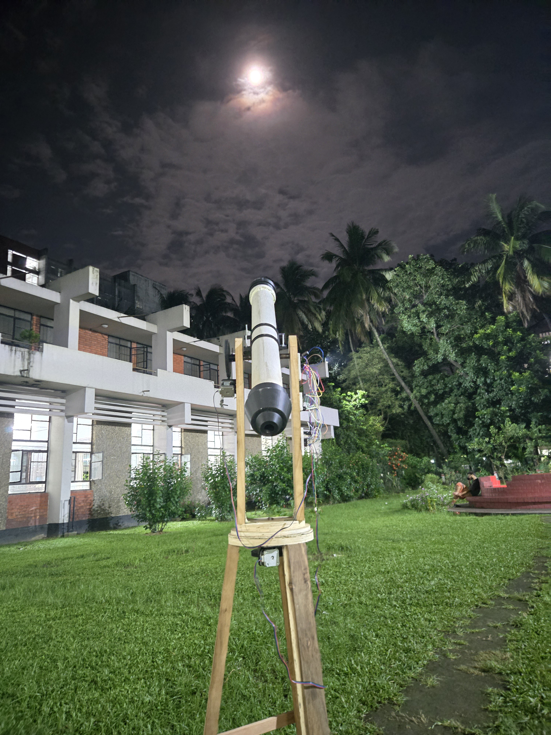
Media/20260926_014432.jpg
